alpop/Arduino-UNO-R3-based-LC-meter/pictures/2.jpg

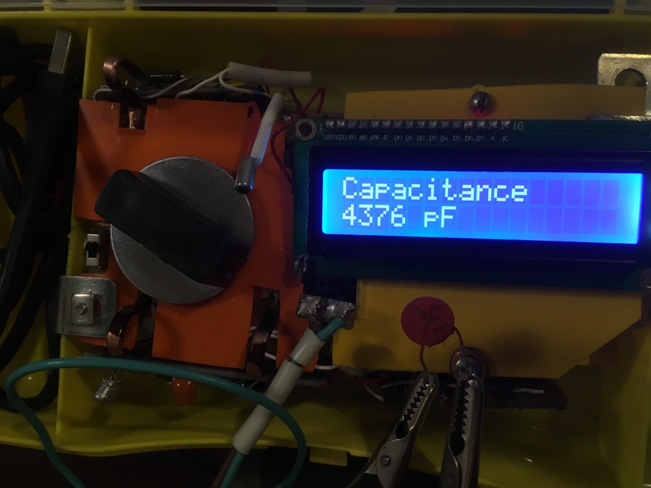
pictures/2.jpg
