alpop/Arduino-UNO-R3-based-LC-meter/pictures/9.jpg

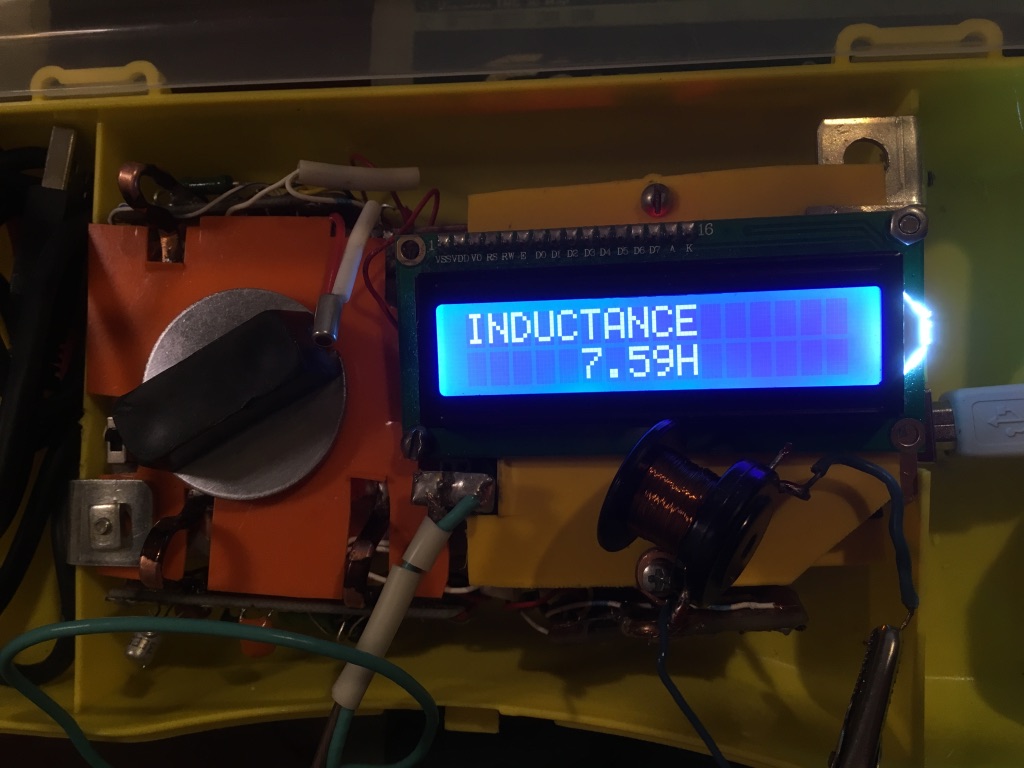
pictures/9.jpg
