alpop/Arduino-UNO-R3-based-LC-meter/pictures/11.jpg

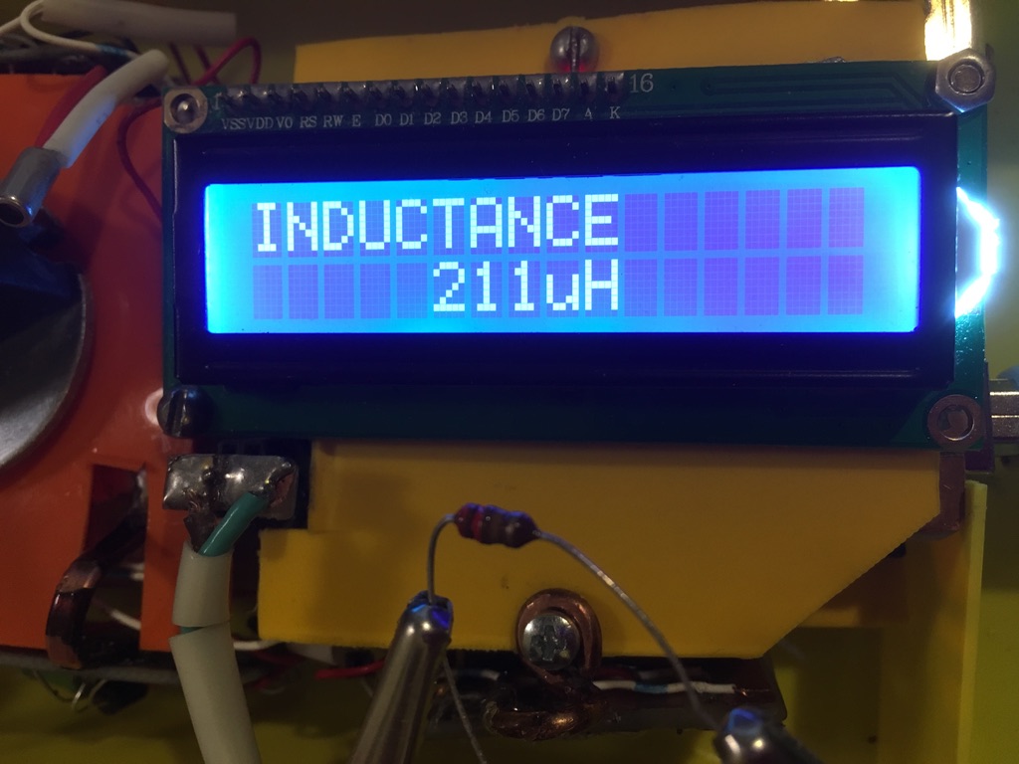
pictures/11.jpg
