alpop/Arduino-UNO-R3-based-LC-meter/pictures/14.jpg

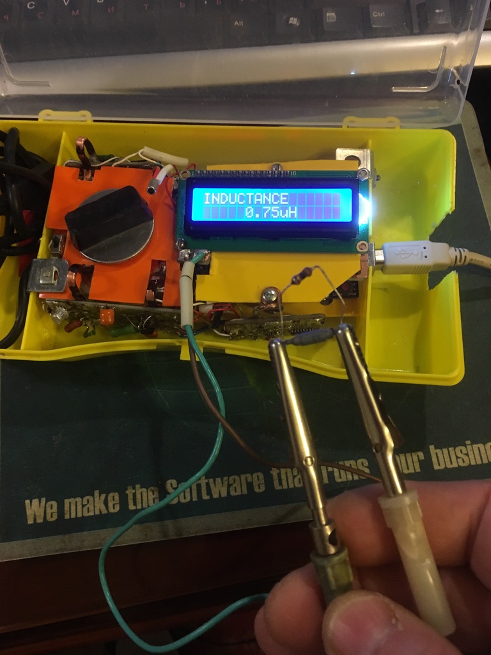
pictures/14.jpg
