alpop/Arduino-UNO-R3-based-LC-meter/pictures/17.jpg

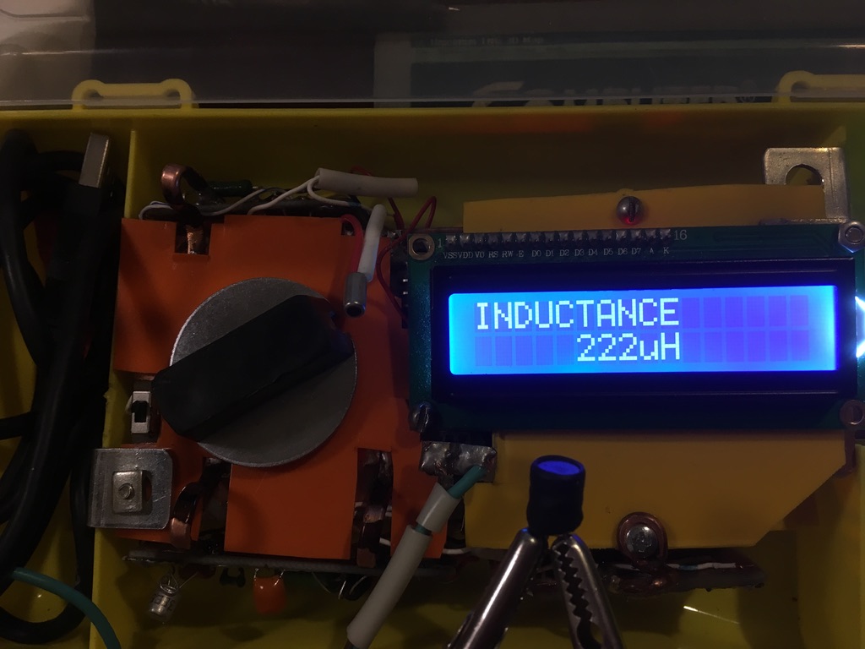
pictures/17.jpg
