alpop/Arduino-UNO-R3-based-LC-meter/pictures/18.jpg

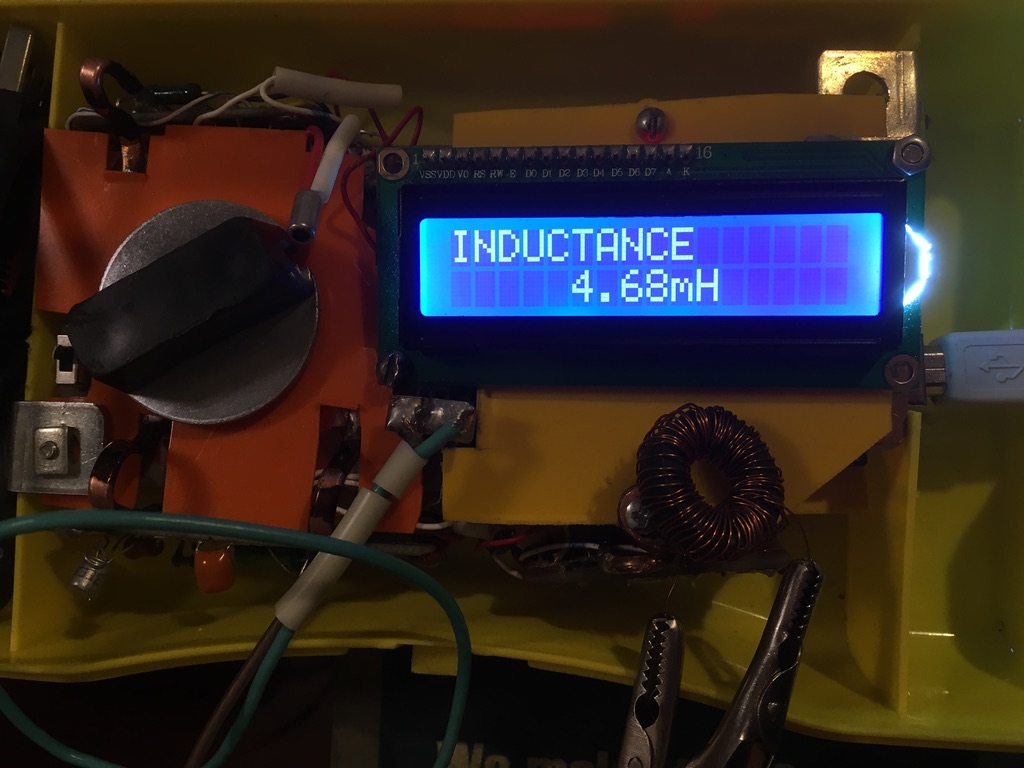
pictures/18.jpg
