alpop/Arduino-UNO-R3-based-LC-meter/pictures/19.jpg

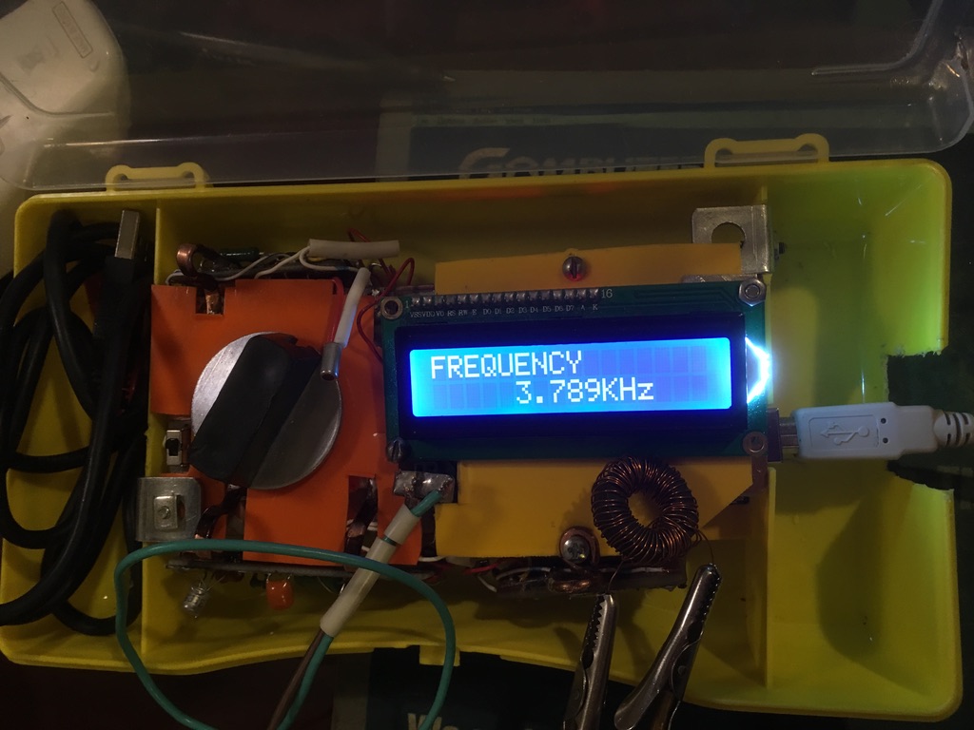
pictures/19.jpg
