alpop/Arduino-UNO-R3-based-LC-meter/pictures/20.jpg

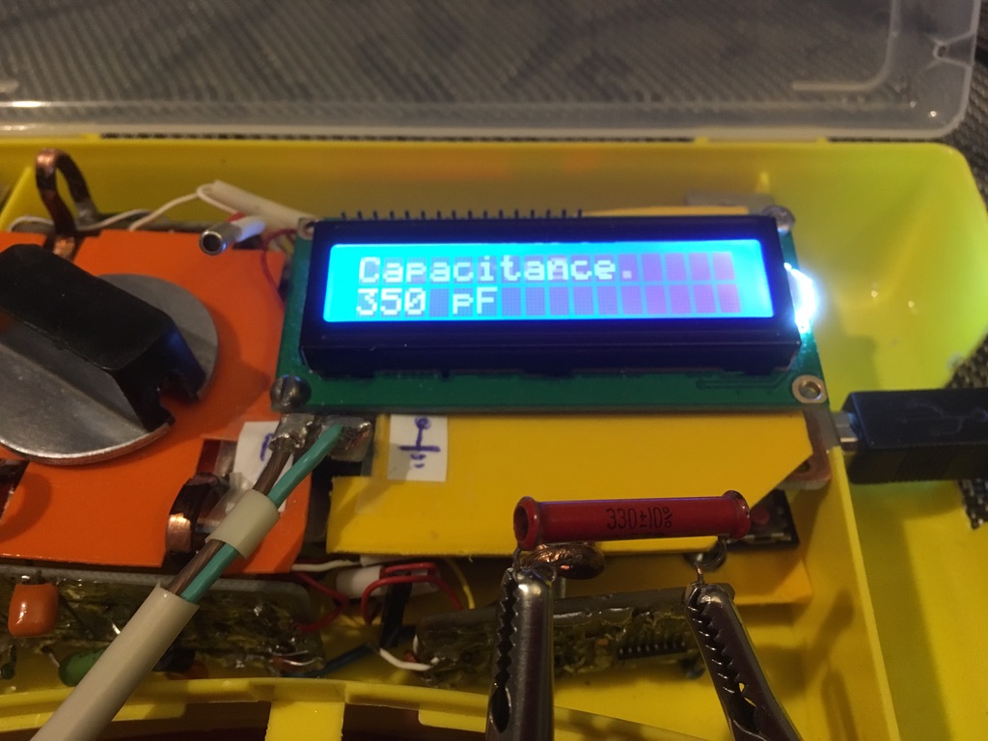
pictures/20.jpg
