alpop/Arduino-UNO-R3-based-LC-meter/pictures/21.jpg

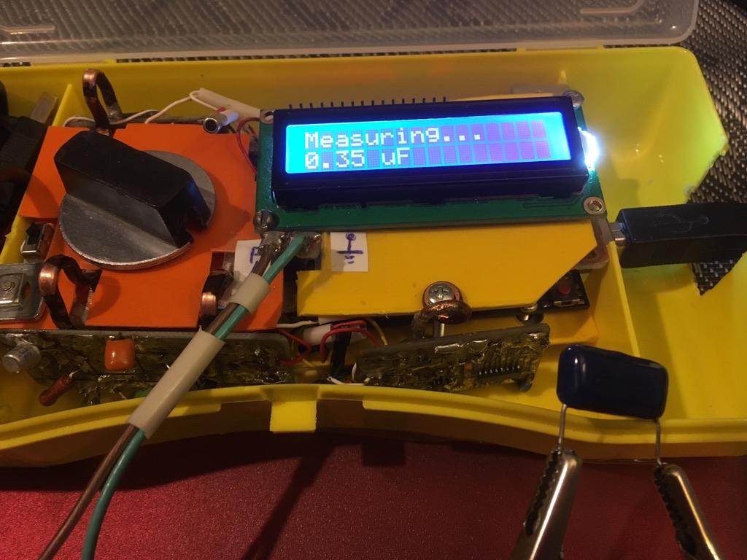
pictures/21.jpg
