alpop/Arduino-UNO-R3-based-LC-meter/pictures/22.jpg

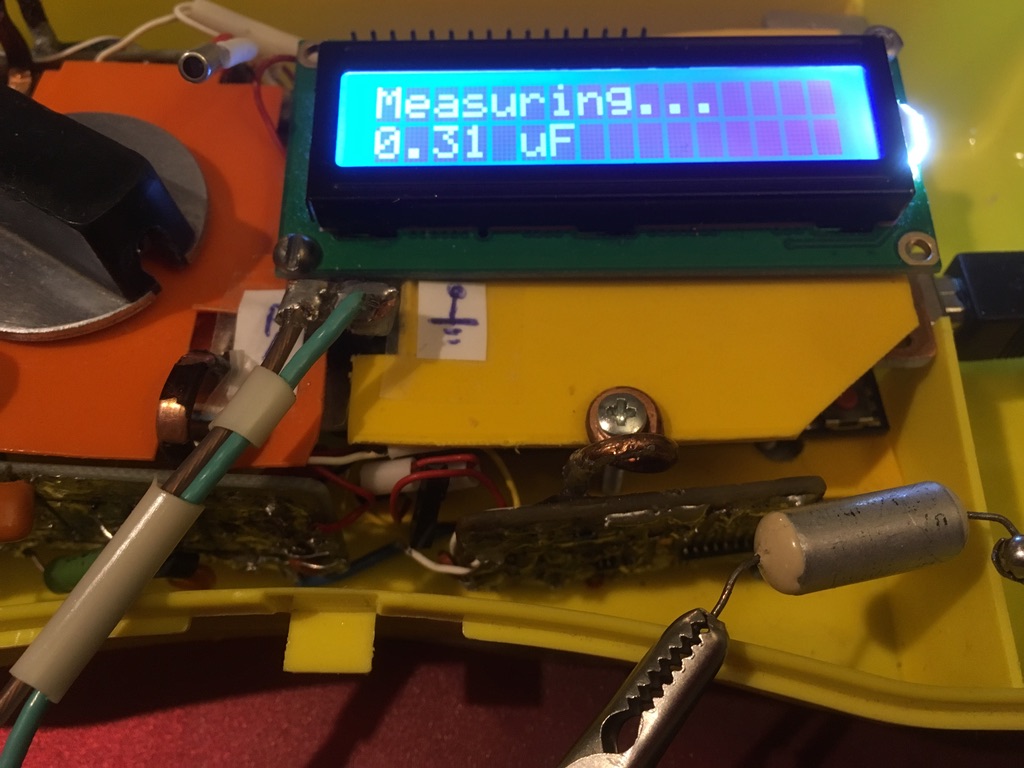
pictures/22.jpg
