alpop/Arduino-UNO-R3-based-LC-meter/LC_meter.pdf

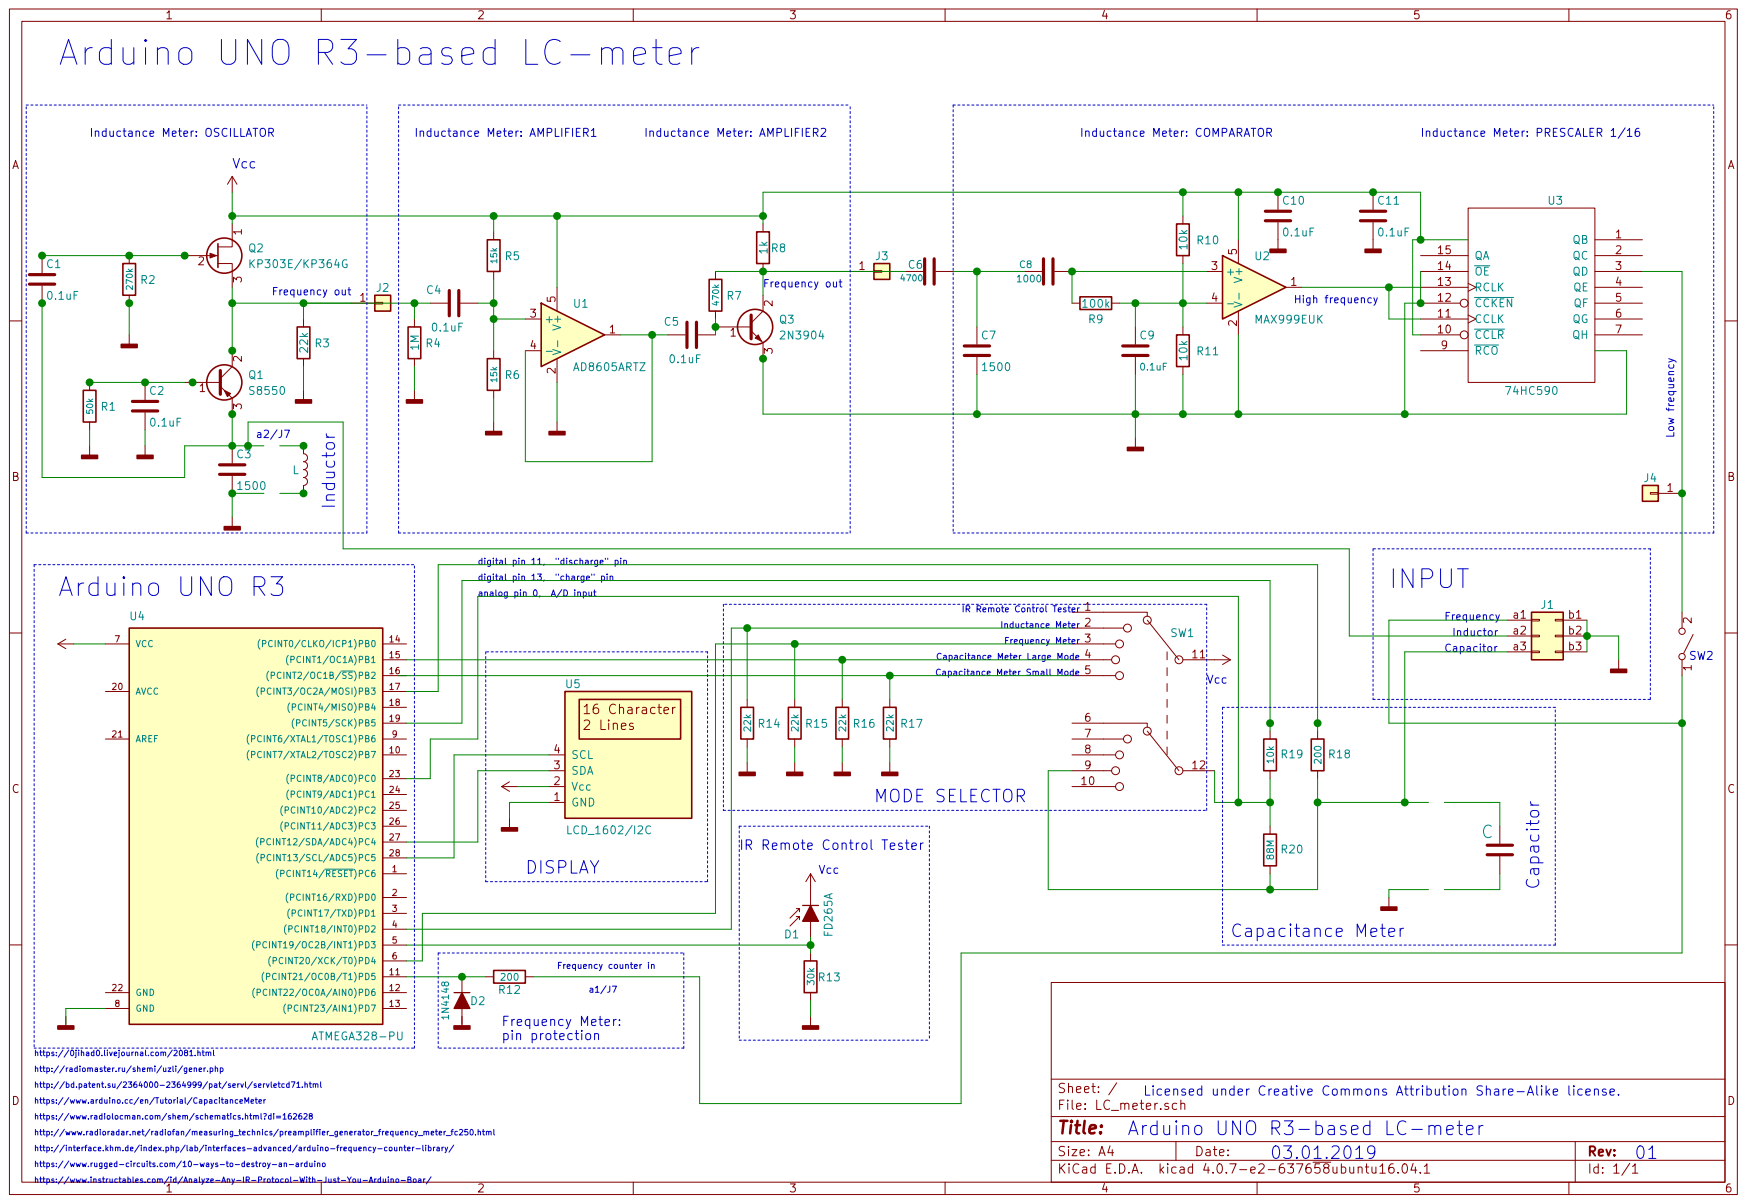
[picture p27: page 1]
